r00li/ipod-dock/img_back.jpg

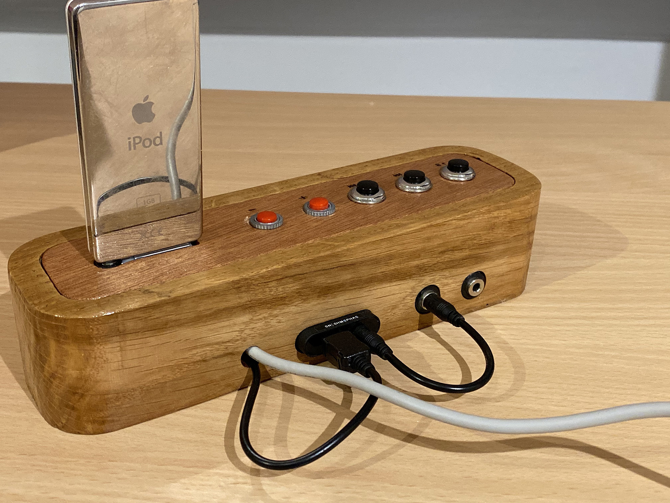
img_back.jpg
